lvitters/RAYARRAY/RAYARRAY.ino

#include <ESP8266WiFi.h>        // Include the Wi-Fi library
const char *ssid = "ESP8266 Access Point"; // The name of the Wi-Fi network that will be created
const char *password = "thereisnospoon";   // The password required to connect to it, leave blank for an open network

#include <AccelStepper.h>
const int stepsPerRevolution = 2048;  // change this to fit the number of steps per revolution

// ULN2003 Motor Driver Pins
#define IN1 5
#define IN2 4
#define IN3 14
#define IN4 12

// 95A Hall sensor analog input
#define Hall_Sensor_Pin A0

// initialize the stepper library
AccelStepper stepper(AccelStepper::HALF4WIRE, IN1, IN3, IN2, IN4);

void setup() {

  //stepper motor
  // initialize the serial port
  Serial.begin(115200);
  // set the speed and acceleration
  stepper.setMaxSpeed(1800);          //max 1950
  stepper.setAcceleration(40000);     //max 50000
  // set target position
  stepper.moveTo(stepsPerRevolution*3);

  //Hall sensor
  pinMode(Hall_Sensor_Pin, INPUT);
  Serial.begin(9600);

  //Wifi
  WiFi.softAP(ssid, password);
}

void loop() {
  // check current stepper motor position to invert direction
  if (stepper.distanceToGo() == 0){
    stepper.moveTo(-stepper.currentPosition());
    Serial.println("Changing direction");
  }

  // move the stepper motor (one step at a time)
  stepper.run();

  if (millis() % 1000 == 0) {
    //hall sensor: read analog voltage
    float voltage;
    voltage = analogRead(Hall_Sensor_Pin);
    Serial.println(voltage);
  }
}
