lvitters/RAYARRAY/RAYARRAY_processing/Ray.pde

class Ray {
	static final int recursionGuardMax = 100;  //TORESEARCH: what does static final actually do?

	PVector origin = new PVector();
	PVector direction = new PVector();
	PVector hitPoint = null;
	Ray nextRay;

	//set the ray's position
	void setOrigin(PVector p) {
		origin.set(p);
	}

	//set the ray's direction
	void setDirection(PVector d) {
		direction.set(d);
	}

	//draw the ray
	void draw() {
		strokeWeight(2);
		stroke(255, 0, 0);
			if (hitPoint != null) {
				line(
						origin.x, 
						origin.y, 
						hitPoint.x, 
						hitPoint.y
					);
			}  else {
				line(
						origin.x, 
						origin.y, 
						origin.x + direction.x * width, 
						origin.y + direction.y * width
					);
			}
	}

	//draw ray, check for hit with nearest mirror, if there is a hit draw ray to there
	//https://www.youtube.com/watch?v=TOEi6T2mtHo&t=490s&ab_channel=TheCodingTrain
	void update() {
		PVector closestHit = null;
		float record = Float.MAX_VALUE;
		Mirror hitMirror = null;
		for (Node n : nodes) {
			if (n.mirror != null) {
				PVector hit = cast(n.mirror);
				if (hit != null) {
					float distance = PVector.dist(origin, hit);
					if (distance < record && distance > n.mirror.mirrorRadius * 2) {
						record = distance;
						closestHit = hit;
						hitMirror = n.mirror;
					}
				}
			}
		}
		//DPP
        if (recursionGuard >= recursionGuardMax ) {
            //println("recursion guard hit");
        }
		if (closestHit != null && hitMirror != null && recursionGuard <= recursionGuardMax) {
			recursionGuard++;
			hitPoint = closestHit;
			nextRay = new Ray();
			nextRay.setOrigin(closestHit);

			//calculate reflection (DPP)
            PVector nextRayDirection = reflect(direction, hitMirror.normal);
            nextRay.setDirection(nextRayDirection);
			
			nextRay.update();
			nextRay.draw();
		} else {
			recursionGuard = 0;
			nextRay = null;
			hitPoint = null;
		}
	}

	//get the direction vector of the reflection (DPP)
	PVector reflect(PVector direction, PVector normal) {
		// r = e - 2 (e.n) n :: ( | n | = 1 )
    	// with e :: direction
    	//      r :: reflection
    	//      n :: normal
		PVector n = new PVector().set(normal).normalize();
		PVector e = new PVector().set(direction);
		float d = PVector.dot(e, n);	// d > 0 = frontface, d < 0 = backface
		n.mult(2 * d);
		PVector r = PVector.sub(e, n);	// it isn't reversed!!!
		return r;
	}

	//determine if it intersects with a mirror
	//https://www.youtube.com/watch?v=TOEi6T2mtHo&t=490s&ab_channel=TheCodingTrain
	PVector cast(Mirror mirror) {
        float x1 = mirror.start.x;
        float y1 = mirror.start.y;
        float x2 = mirror.end.x;
        float y2 = mirror.end.y;

        float x3 = origin.x;
        float y3 = origin.y;
        float x4 = origin.x + direction.x;
        float y4 = origin.y + direction.y;

        float den = (x1 - x2) * (y3 - y4) - (y1 - y2) * (x3 - x4);
        if (den == 0) {
            return null;
        }

        float t =   ((x1 - x3) * (y3 - y4) - (y1 - y3) * (x3 - x4)) / den;
        float u = - ((x1 - x2) * (y1 - y3) - (y1 - y2) * (x1 - x3)) / den;

        if (t > 0 && t < 1 && u > 0) {
            PVector pt = new PVector();
            pt.x = x1 + t * (x2 - x1);
            pt.y = y1 + t * (y2 - y1);
            return pt;
        } else {
            return null;
        }
    }
}
