lvitters/RAYARRAY/(commit log)

2022-10-26 added arduino file
2022-11-21 added Laser class
2022-11-23 went back to before iterator, laser is only moving along y axis now
2022-11-25 attempting too much recursion
    [Laser.pde, RAYARRAY_processing.pde]
2022-12-05 rotate laser diode with 1 and 2 key
2022-12-05 lasers can be added and removed, rotation is still wrong
    [Laser.pde, RAYARRAY_processing.pde]
2022-12-05 switch between mirror, laser and nothing by clicking on the highlighted area on a node
2022-12-05 put ray in own class and draw joints and mirrors behind rays
2022-12-06 switch/case lolol
2023-01-27 with ralf's stuff (but not working)
    [RAYARRAY_arduino.ino, RAYARRAY_processing.pde, osc.ino, ota_update.ino, wifi.ino]
2023-02-09 ID input shows up correctly at corresponding node
    [Node.pde, RAYARRAY_processing.pde]
2023-02-15 working again (dont remember where switchMode() used to be)
2023-02-15 rotation value is sent over to esp correctly
    [Mirror.pde, Node.pde, RAYARRAY_arduino.ino, RAYARRAY_processing.pde, osc.ino, otaupdate.ino]
2023-02-17 something is rotating, but wrong amount
    [Mirror.pde, Node.pde, RAYARRAY_arduino.ino, RAYARRAY_processing.pde]
2023-03-09 tested hall sensor, motor and LED pins with new PCBs
2023-04-04 added GUI buttons
2023-04-05 solved loading and saving bug, some refactoring
    [ControlFrame.pde, Node.pde, RAYARRAY_processing.pde]
2023-04-07 homing working with hard number; NEXT: get lowestVoltage
2023-04-07 refactor, apply direction also in jogging when homing
2023-04-12 homing works multiple times, sending over OSC doesn't work while reading the hall sensor
    [RAYARRAY_arduino.ino, RAYARRAY_processing.pde, osc.ino]
2023-04-12 print the thingy only once
2023-04-17 bulk update worked, green IDs in processing are correct, reset IP when ID is reset
    [Node.pde, RAYARRAY_arduino.ino, RAYARRAY_processing.pde]
2023-04-18 homing maybe working?? (probably not)
2023-04-18 homing works, sendRotation works kinda
2023-04-19 new homing sequence that should work for lasers
2023-04-21 applied rotation speed, go home doesn't send the step anymore (or else home would be false)
    [ControlFrame.pde, Mirror.pde, RAYARRAY_arduino.ino, RAYARRAY_processing.pde]
2023-04-24 GEAR RATIO PRECISION
2023-04-25 send laser rotation to node that has a laser
2023-04-25 weird revolution counting which doesn't work
    [ControlFrame.pde, Laser.pde, Mirror.pde, Node.pde, RAYARRAY_processing.pde]
2023-04-25 lasers point towards grid and know their facingDirection
2023-04-25 lasers rotate according to their facingDirection
2023-04-26 laser moves accordingly
2023-04-26 ich bin etwas auf der spur
2023-04-27 lasers and mirrors move both by hand, or automatically
2023-04-28 JSON also saves if object is a laser or mirror
2023-04-28 node resets its home after every homing sequence
    [RAYARRAY_arduino.ino, osc.ino]
2023-05-02 laser automatic rotation sorta working but no really, is being removed now
2023-05-02 lasers don't rotate by themselves anymore
2023-05-03 laser rotation by hand sorta works
2023-05-04 nodes can be restarted, switchMode after 15 seconds regardless of if all have homed
2023-05-04 actually switching now
2024-07-19 working roughly with new laser holders; "laser" now means that a node as a laser AND a mirror; lasers cannot rotate by themselves anymore they are static
2024-09-24 forgot to increase random int for mode switching according to newRandomModeWeighted()
2024-10-02 added same noise, individual direction
    [ControlFrame.pde, Mirror.pde, RAYARRAY_processing.pde]
2024-10-02 some new modes, switch between all of them, no weighted choice
